IKGB105/EFUSE-LTC4215-Telemetry-STM32/docs/figures/pcb_2d.png

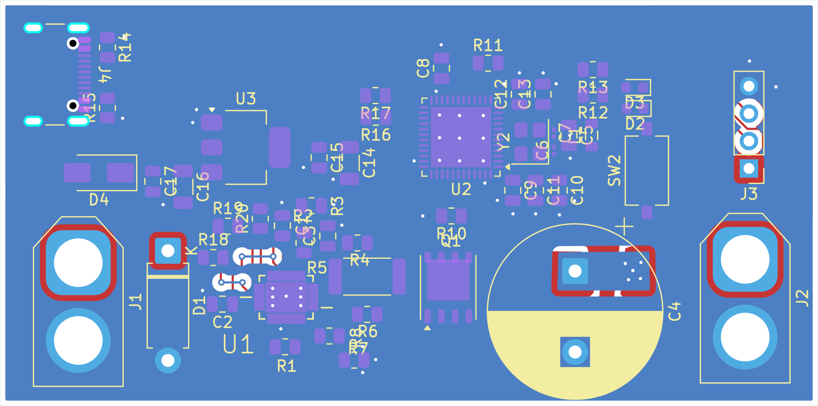
docs/figures/pcb_2d.png
