IKGB105/EFUSE-LTC4215-Telemetry-STM32/docs/reference/Schematic_reduced.png

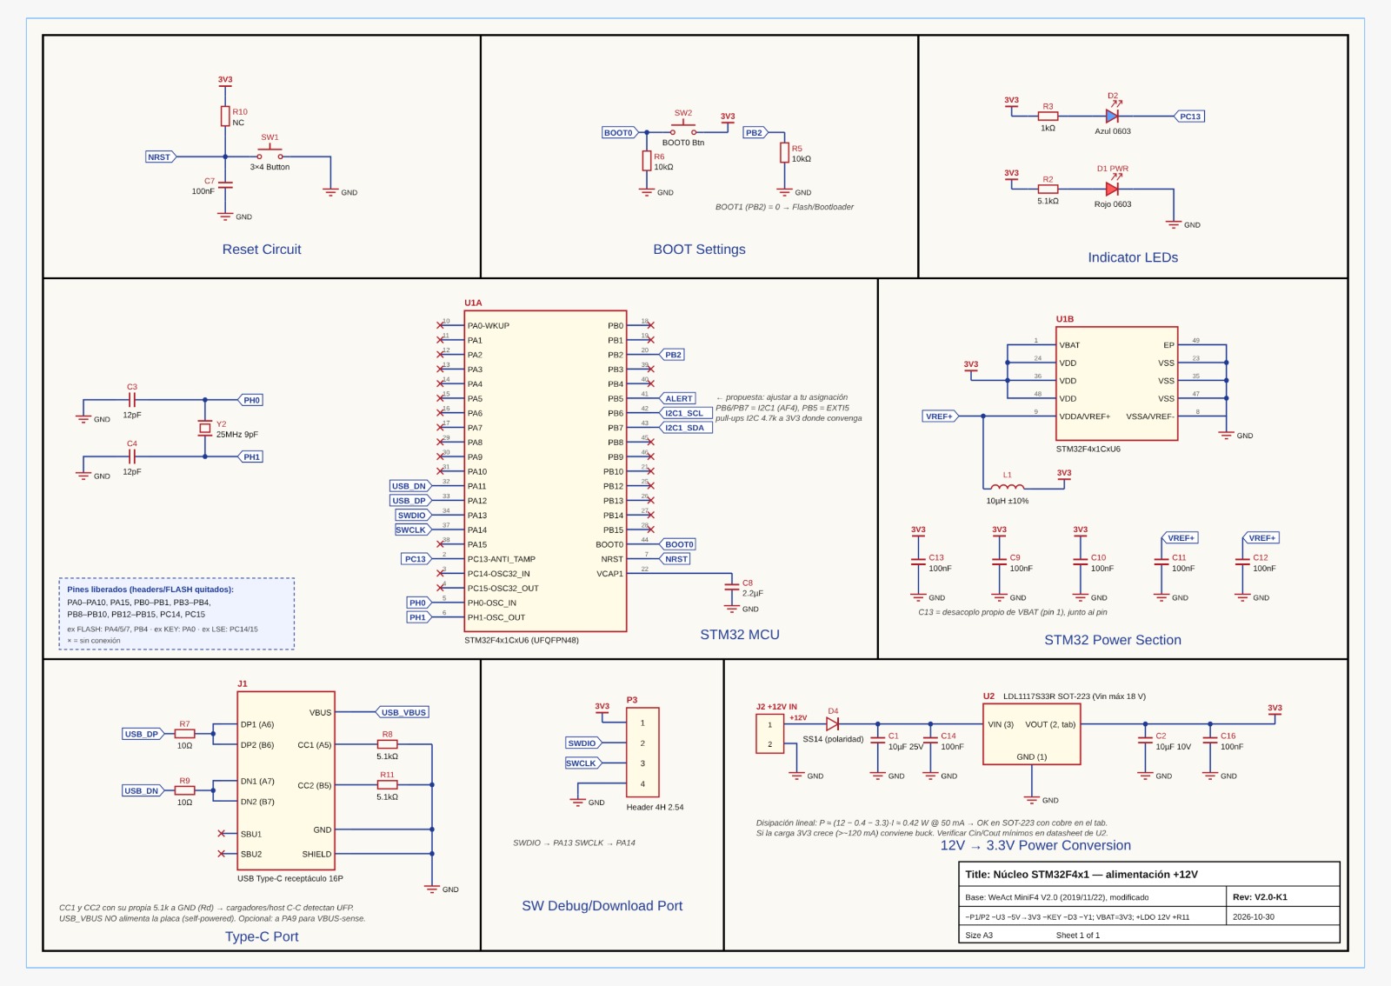
docs/reference/Schematic_reduced.png
