IKGB105/EFUSE-LTC4215-Telemetry-STM32/docs/reference/STM32F411CEU6_WeAct_Black_Pill_V2.0_schematic_EN.png

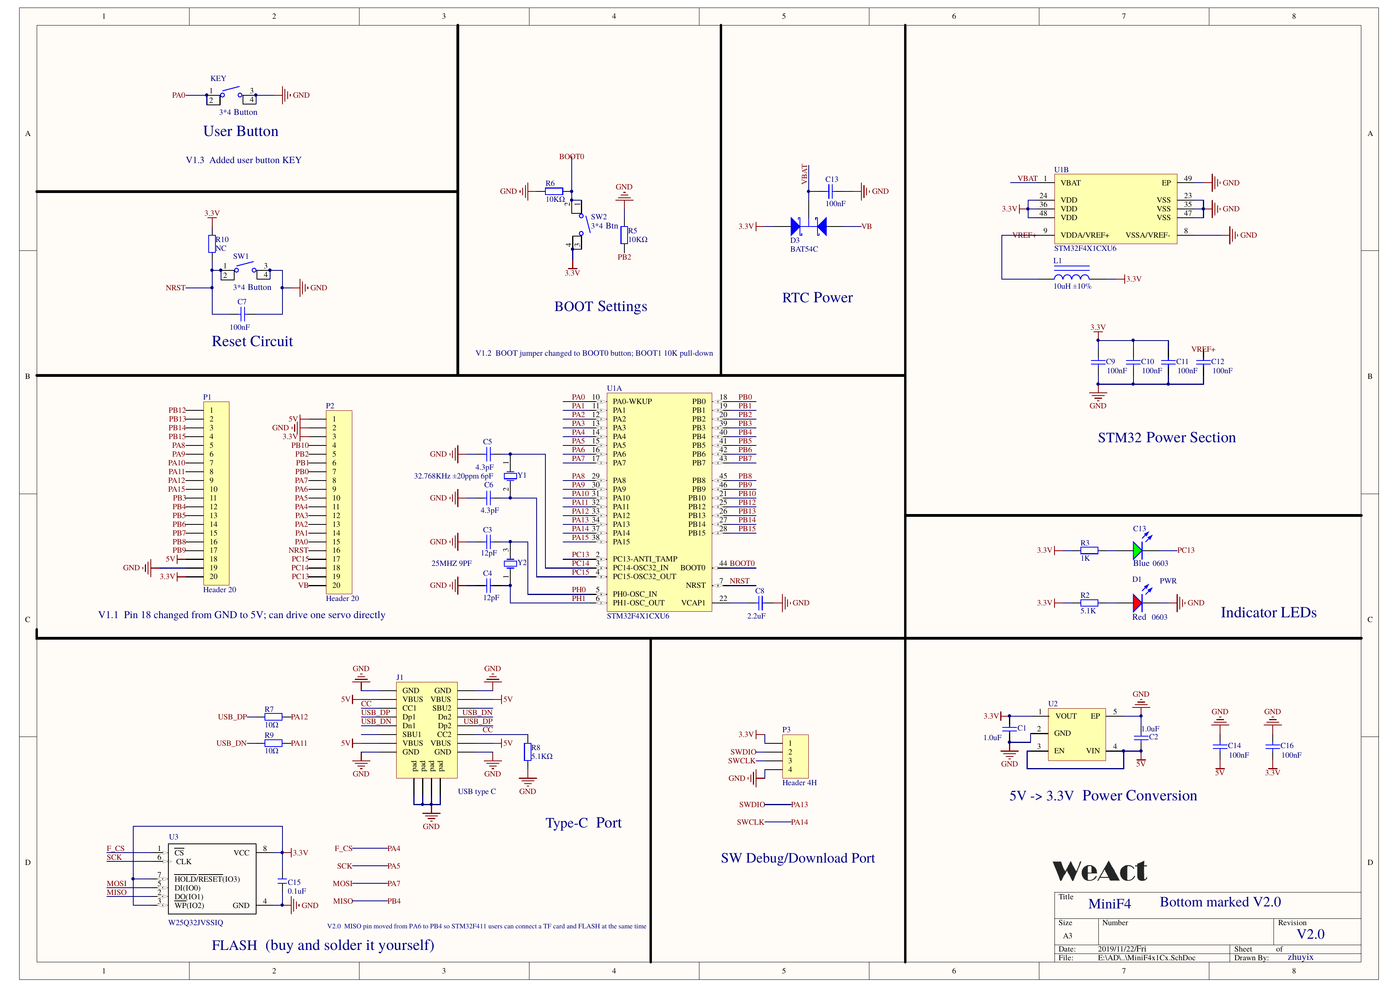
docs/reference/STM32F411CEU6_WeAct_Black_Pill_V2.0_schematic_EN.png
