IKGB105/EFUSE-LTC4215-Telemetry-STM32/kicad/EFUSE_TELEMETRY/EFUSE_TELEMETRY.kicad_pcb

## KiCad design kicad/EFUSE_TELEMETRY/EFUSE_TELEMETRY.kicad_pcb (2026-10-31)

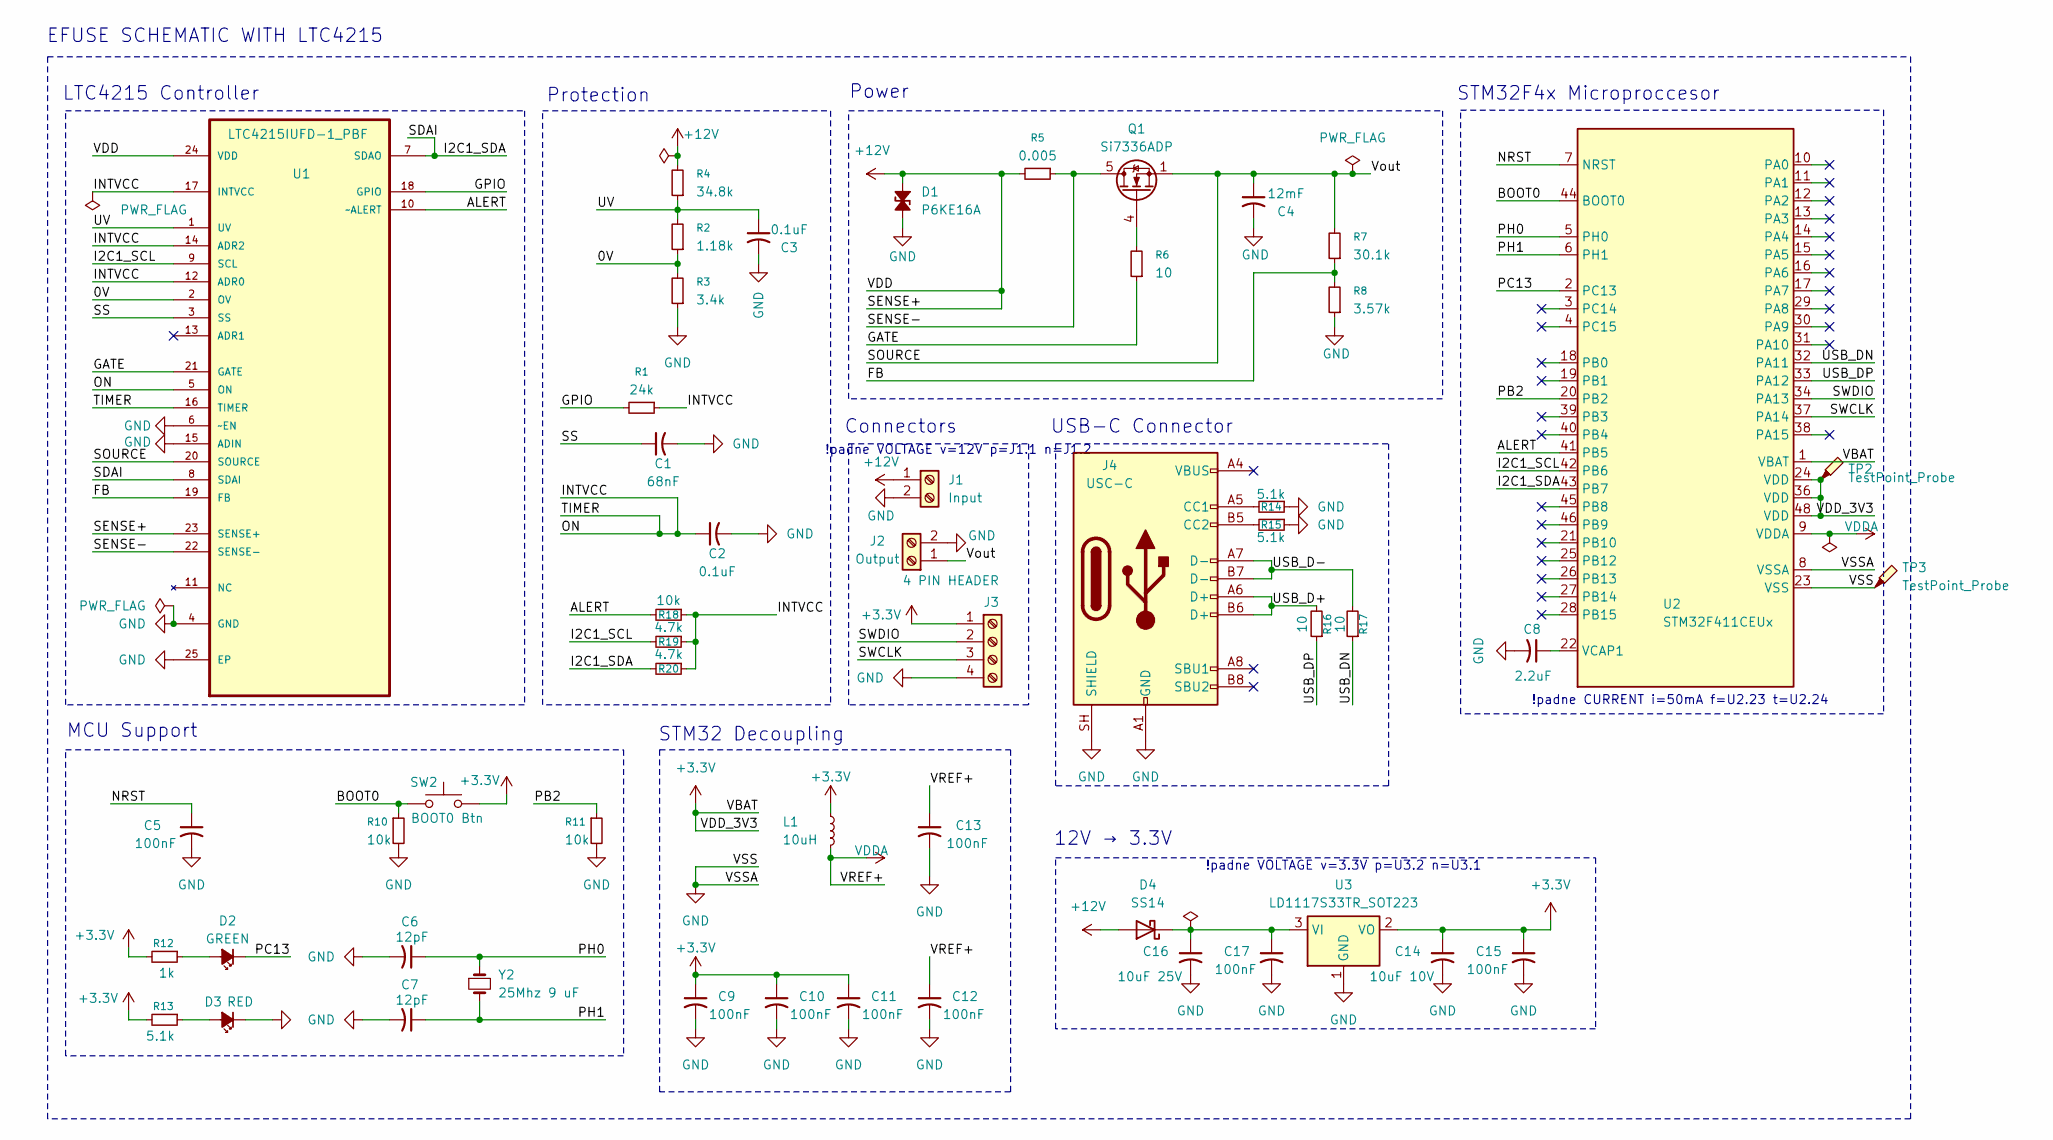
[picture p10: schematic EFUSE_TELEMETRY.kicad_sch, EFUSE-LTC4215IUFD with STM32 TELEMETRY]

Parts:
C1: 68nF; C_0805_2012Metric
C2, C3: 0.1uF; C_0805_2012Metric
C4: 12mF; CP_Radial_D16.0mm_P7.50mm
C5, C9, C10, C11, C12, C13, C15, C17: 100nF; C_0805_2012Metric
C6, C7: 12pF; C_0201_0603Metric
C8: 2.2uF; C_0805_2012Metric
C14: 10uF 10V; C_1206_3216Metric
C16: 10uF 25V; C_1206_3216Metric
D1: P6KE16A; D_DO-15_P10.16mm_Horizontal
D2: GREEN; LED_0603_1608Metric
D3: RED; LED_0603_1608Metric
D4: SS14; D_SMA
J1: Input; AMASS_XT60-M_1x02_P7.20mm_Vertical
J2: Output; AMASS_XT60-M_1x02_P7.20mm_Vertical
J3: 4 PIN HEADER; PinHeader_1x04_P2.54mm_Vertical
J4: USC-C; USB_C_Receptacle_GCT_USB4105-xx-A_16P_TopMnt_Horizontal
L1: 10uH; L_0805_2012Metric
Q1: Si7336ADP; PowerPAK_SO-8_Single
R1: 24k; R_0805_2012Metric
R2: 1.18k; R_0805_2012Metric
R3: 3.4k; R_0805_2012Metric
R4: 34.8k; R_0805_2012Metric
R5: 0.005; R_2512_6332Metric
R6, R16, R17: 10; R_0805_2012Metric
R7: 30.1k; R_0805_2012Metric
R8: 3.57k; R_0805_2012Metric
R10, R11, R18: 10k; R_0805_2012Metric
R12: 1k; R_0805_2012Metric
R13, R14, R15: 5.1k; R_0805_2012Metric
R19, R20: 4.7k; R_0805_2012Metric
SW2: BOOT0 Btn; SW_Tactile_SPST_NO_Straight_CK_PTS636Sx25SMTRLFS
TP2, TP3: TestPoint_Probe; TestPoint_Keystone_5000-5004_Miniature
U1: LTC4215IUFD-1_PBF; QFN50P400X500X80-25N; MPN LTC4215IUFD-2#TRPBF; DigiKey_Part_Number LTC4215IUFD-1#PBF-ND
U2: STM32F411CEUx; QFN-48-1EP_7x7mm_P0.5mm_EP5.6x5.6mm
U3: LD1117S33TR_SOT223; SOT-223-3_TabPin2
Y2: 25Mhz 9 uF; Crystal_SMD_3225-4Pin_3.2x2.5mm

Connections:
+3.3V: C9.1, C10.1, C11.1, C14.1, C15.1, J3.1, L1.1, R12.2, R13.2, SW2.2, TP2.1 (1_1), U2.1 (VBAT), U2.24 (VDD), U2.36 (VDD), U2.48 (VDD), U3.2 (VO)
+12V: D1.1 (A1), D4.2 (A), J1.1, R4.2, R5.2, U1.23 (SENSE+), U1.24 (VDD)
/0V: R2.1, R3.2, U1.2 (OV)
/ALERT: R18.2, U1.10 (~ALERT), U2.41 (PB5)
/BOOT0: R10.1, SW2.1, U2.44 (BOOT0)
/FB: R7.1, R8.2, U1.19 (FB)
/GATE: R6.1, U1.21 (GATE)
/GPIO: R1.2, U1.18 (GPIO)
/I2C1_SCL: R19.2, U1.9 (SCL), U2.42 (PB6)
/I2C1_SDA: R20.2, U1.7 (SDAO), U1.8 (SDAI), U2.43 (PB7)
/INTVCC: C2.1, R1.1, R18.1, R19.1, R20.1, U1.5 (ON), U1.12 (ADR0), U1.14 (ADR2), U1.16 (TIMER), U1.17 (INTVCC)
/NRST: C5.1, U2.7 (NRST)
/PB2: R11.1, U2.20 (PB2)
/PC13: D2.1 (K), U2.2 (PC13)
/PH0: C6.1, U2.5 (PH0), Y2.1
/PH1: C7.1, U2.6 (PH1), Y2.2
/SENSE-: Q1.5 (D), R5.1, U1.22 (SENSE-)
/SOURCE: C4.1, J2.1, Q1.1 (S), Q1.2 (S), Q1.3 (S), R7.2, U1.20 (SOURCE)
/SS: C1.1, U1.3 (SS)
/SWCLK: J3.3, U2.37 (PA14)
/SWDIO: J3.2, U2.34 (PA13)
/USB_D+: J4.A6 (D+), J4.B6 (D+), R16.2
/USB_D-: J4.A7 (D-), J4.B7 (D-), R17.2
/USB_DN: R17.1, U2.32 (PA11)
/USB_DP: R16.1, U2.33 (PA12)
/UV: C3.1, R2.2, R4.1, U1.1 (UV)
GND: C1.2, C2.2, C3.2, C4.2, C5.2, C6.2, C7.2, C8.2, C9.2, C10.2, C11.2, C12.2, C13.2, C14.2, C15.2, C16.2, C17.2, D1.2 (A2), D3.1 (K), J1.2, J2.2, J3.4, J4.A1 (GND), J4.A12 (GND), J4.B1 (GND), J4.B12 (GND), J4.SH (SHIELD), R3.1, R8.1, R10.2, R11.2, R14.1, R15.1, TP3.1 (1_1), U1.4 (GND), U1.6 (~EN), U1.15 (ADIN), U1.25 (EP), U2.8 (VSSA), U2.23 (VSS), U2.35 (VSS), U2.47 (VSS), U2.49 (VSS), U3.1 (GND)
unnamed: D2.2 (A), R12.1
unnamed: D3.2 (A), R13.1
unnamed: C16.1, C17.1, D4.1 (K), U3.3 (VI)
unnamed: J4.A5 (CC1), R14.2
unnamed: J4.B5 (CC2), R15.2
unnamed: Q1.4 (G), R6.2
unnamed: C8.1, U2.22 (VCAP1)
VDDA: C12.1, C13.1, L1.2, U2.9 (VDDA)

Notes on the sheet:
STM32F4x Microproccesor
Power
!padne CURRENT i=50mA f=U2.23 t=U2.24
MCU Support
STM32 Decoupling
!padne VOLTAGE v=3.3V p=U3.2 n=U3.1
Connectors
!padne VOLTAGE v=12V p=J1.1 n=J1.2
Protection
12V → 3.3V
LTC4215 Controller
EFUSE SCHEMATIC WITH LTC4215
USB-C Connector

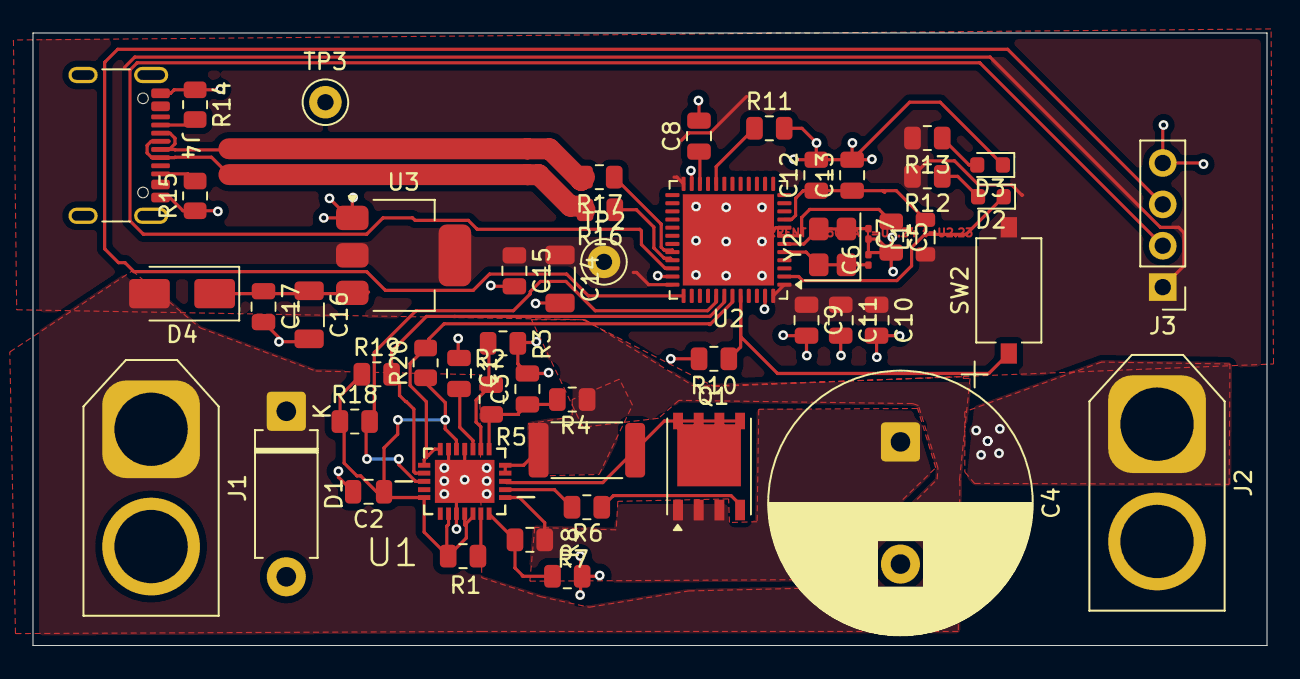
[picture p11: board EFUSE_TELEMETRY.kicad_pcb from above]

Board: 2 copper layers, 75.8 x 37.6 mm, 53 parts (0 on the bottom side), 35 nets.
