IKGB105/EFUSE-LTC4215-Telemetry-STM32/code/EFUSE_TELEMETRY/Core/Src/main.c

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
/* Includes ------------------------------------------------------------------*/
#include "main.h"
#include "i2c.h"
#include "usb_device.h"
#include "gpio.h"

/* USER CODE BEGIN Includes */
#include <stdio.h>
#include "ltc4215.h"
#include "usbd_cdc_if.h"
/* USER CODE END Includes */


void SystemClock_Config(void);
/**
  * @brief  The application entry point.
  * @retval int
  */
int main(void)
{

  /* MCU Configuration--------------------------------------------------------*/

  /* Reset of all peripherals, Initializes the Flash interface and the Systick. */
  HAL_Init();

  /* Configure the system clock */
  SystemClock_Config();

  /* Initialize all configured peripherals */
  MX_GPIO_Init();
  MX_I2C1_Init();
  MX_USB_DEVICE_Init();
  /* USER CODE BEGIN 2 */
  /* Clear any fault bits latched before the MCU came up. */
  ltc4215_clear_faults(&hi2c1);
  uint32_t last_poll_tick = HAL_GetTick();
  /* USER CODE END 2 */

  /* Infinite loop */
  /* USER CODE BEGIN WHILE */
  while (1)
  {
    /* USER CODE END WHILE */

    /* USER CODE BEGIN 3 */
    if ((HAL_GetTick() - last_poll_tick) >= 500U) {
      last_poll_tick = HAL_GetTick();

      LTC4215_Status status;
      LTC4215_Fault fault;
      LTC4215_Telemetry telemetry;
      char line[96];
      int len;

      if (ltc4215_read_status(&hi2c1, &status) == HAL_OK &&
          ltc4215_read_fault(&hi2c1, &fault) == HAL_OK &&
          ltc4215_read_telemetry(&hi2c1, &telemetry) == HAL_OK) {
        len = snprintf(line, sizeof(line),
                        "I=%lumA Vout=%lumV FET=%d PGOOD=%d OC=%d UV=%d OV=%d\r\n",
                        (unsigned long)telemetry.current_ma,
                        (unsigned long)telemetry.source_mv,
                        status.fet_on ? 1 : 0,
                        status.power_bad ? 0 : 1,
                        fault.overcurrent_occurred ? 1 : 0,
                        fault.undervoltage_occurred ? 1 : 0,
                        fault.overvoltage_occurred ? 1 : 0);
      } else {
        len = snprintf(line, sizeof(line), "LTC4215 I2C read failed\r\n");
      }
      if (len > 0) {
        CDC_Transmit_FS((uint8_t *)line, (uint16_t)len);
      }
    }
  }
  /* USER CODE END 3 */
}

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
