IKGB105/EFUSE-LTC4215-Telemetry-STM32/code/EFUSE_TELEMETRY/EFUSE_TELEMETRY.ioc

Mcu.UserName=STM32F411CEUx
PA11.Signal=USB_OTG_FS_DM
PA12.Signal=USB_OTG_FS_DP
PB6.Signal=I2C1_SCL
PB7.Signal=I2C1_SDA
