IKGB105/EFUSE-LTC4215-Telemetry-STM32/kicad/EFUSE_TELEMETRY/EFUSE_TELEMETRY.kipi-setup.yml

vrms:
- name: U1
  output:
    ref: U1
    net: +12V
    pins: []
  voltage: 12.0
  kind: source
  efficiency: 0.9
  quiescent_a: 0.0
  input: null
  sense:
    ref: U2
    net: +3.3V
    pins: []
  ground:
    ref: U1
    net: GND
    pins: []
  input_ground: null
  ground_sense:
    ref: TP3
    net: GND
    pins: []
  phases: []
  current_limit_a: null
  dropout_v: 0.0
  vin_min: null
  vin_max: null
  vin_pct: false
  vin_dv: false
  acc_min: null
  acc_max: null
  acc_pct: true
  acc_dv: false
  load_line_mohm: 0.0
  bandwidth_khz: 50.0
  mesh_sense: false
  sense_points: []
- name: U3
  output:
    ref: U3
    net: +3.3V
    pins: []
  voltage: 3.3
  kind: source
  efficiency: 0.9
  quiescent_a: 0.0
  input: null
  sense:
    ref: U2
    net: +3.3V
    pins: []
  ground:
    ref: U3
    net: GND
    pins: []
  input_ground: null
  ground_sense:
    ref: U2
    net: GND
    pins: []
  phases: []
  current_limit_a: null
  dropout_v: 0.0
  vin_min: null
  vin_max: null
  vin_pct: false
  vin_dv: false
  acc_min: null
  acc_max: null
  acc_pct: true
  acc_dv: false
  load_line_mohm: 1.0
  bandwidth_khz: 50.0
  mesh_sense: false
  sense_points: []
loads:
- name: FUSE
  supply:
    ref: U1
    net: +12V
    pins: []
  current: 0.005
  ground:
    ref: U1
    net: GND
    pins: []
  tol_min: null
  tol_max: null
  tol_pct: true
  tol_dv: false
  dc_tol_min: null
  dc_tol_max: null
  dc_tol_pct: true
  dc_tol_dv: false
  ac_tol_min: null
  ac_tol_max: null
  ac_tol_pct: true
  ac_tol_dv: false
  groups: []
- name: CHIP
  supply:
    ref: U2
    net: +3.3V
    pins: []
  current: 0.05
  ground:
    ref: U2
    net: GND
    pins: []
  tol_min: null
  tol_max: null
  tol_pct: true
  tol_dv: false
  dc_tol_min: null
  dc_tol_max: null
  dc_tol_pct: true
  dc_tol_dv: false
  ac_tol_min: null
  ac_tol_max: null
  ac_tol_pct: true
  ac_tol_dv: false
  groups: []
links: []
settings:
  max_edge_mm: 0.5
  min_angle_deg: 28.0
  simplify_mm: 0.003
  circle_quad_segs: 4
  min_edge_mm: 0.02
  grading: 0.2
  via_rules:
  - kind: micro
    plating_mm: 0.012
    drill_min_mm: 0.0
    drill_max_mm: null
    fill: nonconductive
    fill_rho_ohm_mm: null
  - kind: buried
    plating_mm: 0.013
    drill_min_mm: 0.0
    drill_max_mm: null
    fill: nonconductive
    fill_rho_ohm_mm: null
  - kind: blind
    plating_mm: 0.02
    drill_min_mm: 0.0
    drill_max_mm: null
    fill: nonconductive
    fill_rho_ohm_mm: null
  - kind: blind_buried
    plating_mm: 0.02
    drill_min_mm: 0.0
    drill_max_mm: null
    fill: nonconductive
    fill_rho_ohm_mm: null
  - kind: through
    plating_mm: 0.02
    drill_min_mm: 0.0
    drill_max_mm: null
    fill: nonconductive
    fill_rho_ohm_mm: null
  - kind: pth
    plating_mm: 0.02
    drill_min_mm: 0.0
    drill_max_mm: null
    fill: nonconductive
    fill_rho_ohm_mm: null
  - kind: any
    plating_mm: 0.02
    drill_min_mm: 0.0
    drill_max_mm: null
    fill: nonconductive
    fill_rho_ohm_mm: null
  rho_ohm_mm: 1.724e-05
  tcr_per_c: 0.00393
  rho_by_layer: {}
  tcr_by_layer: {}
  conductor_by_layer: {}
  tol: 1.0e-10
  max_iter: 2000
  large_pads_as_copper: false
  large_pad_mm2: 10.0
  pad_contact_share: 0.25
via_current_limit_a: 1.0
thermal:
  enabled: true
  ambient_c: 25.0
  iterations: 3
  airflow_m_s: 0.0
  grid_mm: 0.0
  load_power: true
  max_temp_c: null
  max_rise_c: null
html_report: false
report_format: html
nets:
- +12V
- +3.3V
- /0V
- /SOURCE
- unconnected-(J4-VBUS-PadA4)
- unconnected-(J4-VBUS-PadA4)_1
- unconnected-(J4-VBUS-PadA4)_2
- unconnected-(J4-VBUS-PadA4)_3
- VDDA
- GND
excluded_nets: []
stackup: null
caps: []
probes: []
packages: []
ac:
  f_start_hz: 1000.0
  f_stop_hz: 300000000.0
  points_per_decade: 250
  field_points_per_decade: 20
  max_edge_mm: 1.0
  grading: 0.3
  min_edge_mm: 0.03
  grade_near_rail_only: true
  coarsen_far: true
  far_max_edge_mm: 5.0
  loss_tangent: 0.02
  default_er: 4.3
  rail: U3
  ground: GND
  html_report: false
  report_format: html
  dc_bias: true
  mfg_tolerance: false
  aging: false
  aging_hours: 87600.0
  temperature: none
  temperature_c: 25.0
aggressors: []
victims: []
noise:
  aggressor: ''
  f_max_hz: null
  max_harmonics: 4000
  periods_shown: 2
  dead_time_ns: 20.0
  segment_mm: 0.5
  window_mm: 3.0
  board_model: true
  field_per_decade: 10
  victims: all
  scan: false
  scan_radius_mm: 10.0
  scan_top_n: 10
  scan_preset: hiz
  scan_driver_ohm: 33.0
  scan_logic_v: 3.3
  html_report: false
  report_format: html
format_version: 2
