IKGB105/EFUSE-LTC4215-Telemetry-STM32/(commit log)

2026-10-31 Add STM32F411CEU6 I2C telemetry front-end for the LTC4215 eFuse
    Minimal STM32F411CEU6 system (clock, power, USB-DFU, SWD) wired to the
    LTC4215's I2C/SMBus monitoring interface, which the original eFuse
    design left unused. Schematic and PCB are ERC/DRC clean; report covers
    MCU selection, I2C integration, layout decisions, and every pitfall
    found along the way.
    [EFUSE_TELEMETRY.kicad_pcb, EFUSE_TELEMETRY.kicad_sch]
2026-10-31 Finish layout debugging, add DC PDN analysis
    Closed out ERC/DRC (crystal net assignment, INTVCC/ALERT bridge
    routing, SOURCE pour clearance, I2C pull-up placement) -- remaining
    DRC entries are inherent to the USB-C footprint, not real issues.
    Added a DC power-delivery-network check with padne: 3.3V/GND plane
    shows at most 148uV of drop under the STM32's load. AC impedance
    sweep tooling (KiPI) is installed and loads the board; sweep setup
    is still pending.
    [EFUSE_TELEMETRY.kicad_pcb, EFUSE_TELEMETRY.kicad_sch]
2026-10-31 Add LTC4215 I2C driver and STM32CubeMX firmware skeleton
    STM32CubeMX project (I2C1 on PB6/PB7, USB_OTG_FS device-only with
    VBUS sensing disabled, USB_DEVICE as CDC) plus a hand-written LTC4215
    register driver: CONTROL/ALERT/STATUS/FAULT/SENSE/SOURCE/ADIN per
    the datasheet's Tables 2-8, polling status/fault/telemetry every
    500ms and streaming it over USB-CDC.
    Verified without any physical board: compiles clean against the real
    HAL (CMake + arm-none-eabi-gcc, 0 warnings), and the register
    conversion math is checked on the host against datasheet-derived
    synthetic bytes (code/test/ltc4215_regmap_test.c, 11/11 pass).
    Also folds the firmware/driver work into the report and README.
