IKGB105/EFUSE-LTC4215-Telemetry-STM32/(notices)

Notices in the files:
code/EFUSE_TELEMETRY/Core/Src/main.c:
Copyright (c) 2026 STMicroelectronics.
All rights reserved.
This software is licensed under terms that can be found in the LICENSE file
